andreban/neopixel-star/xiao/fab/jlcpcb/bom.csv

Comment | Designator | Footprint | LCSC Part #
10u | C1 | C_0603_1608Metric | C19702
WS2812B-Mini | LED1,LED2,LED3,LED4,LED5,LED6,LED7,LED8,LED9 | LED_WS2812B-Mini_PLCC4_3.5x3.5mm | C52941386
330 | R1 | R_0603_1608Metric | C23138
XIAO RP2350 | U1 | XIAO_Socket_2x07_P2.54mm_W15.24mm | C41882923
