andreban/neopixel-star/xiao/fab/pcbway/bom.csv

Item # | Designator | Qty | Manufacturer | Mfg Part # | Description / Value | Package/Footprint | Type | LCSC Part #
1 | C1 | 1 | Samsung | CL10A106KP8NNNC | 10u - 10 uF 10 V X5R 0603, bulk | C_0603_1608Metric | THT | C19702
2 | LED1,LED2,LED3,LED4,LED5,LED6,LED7,LED8,LED9 | 9 | Worldsemi | WS2812B-MINI-V6 | WS2812B-Mini - Addressable RGB LED, 3535 | LED_WS2812B-Mini_PLCC4_3.5x3.5mm | THT | C52941386
3 | R1 | 1 | UNI-ROYAL | 0603WAF3300T5E | 330 - 330 R 1% 0603, data series resistor | R_0603_1608Metric | THT | C23138
4 | U1 | 1 | Seeed Studio | 102010550 | XIAO RP2350 - Seeed Studio XIAO RP2350 in 2.54 mm female headers (any XIAO fits) | XIAO_Socket_2x07_P2.54mm_W15.24mm | THT | C41882923
