andreban/neopixel-star/tht/fab/jlcpcb/bom.csv

Comment | Designator | Footprint | LCSC Part #
10u | C1 | CP_Radial_D5.0mm_P2.00mm | C43347
JST-PH 3p | J1 | JST_PH_S3B-PH-K_1x03_P2.00mm_Horizontal | C157929
WS2812D-F5 | LED1,LED2,LED3,LED4,LED5,LED6,LED7,LED8,LED9 | LED_D5.0mm-4_RGB_Staggered_Pins | C190565
330 | R1 | R_Axial_DIN0207_L6.3mm_D2.5mm_P2.54mm_Vertical | C119313
