andreban/neopixel-star/smd/fab/jlcpcb/bom.csv

Comment | Designator | Footprint | LCSC Part #
100n | C1,C2,C3,C4,C5,C6,C7,C8,C9,C11 | C_0402_1005Metric | C1525
10u | C10 | C_0805_2012Metric | C15850
JST-PH 3p | J1 | JST_PH_S3B-PH-SM4-TB_1x03-1MP_P2.00mm_Horizontal | C265101
WS2812B | LED1,LED2,LED3,LED4,LED5,LED6,LED7,LED8,LED9 | LED_WS2812B_PLCC4_5.0x5.0mm_P3.2mm | C2761795
330 | R1 | R_0402_1005Metric | C25104
100k | R2 | R_0402_1005Metric | C25741
74AHCT1G125 | U1 | SOT-23-5 | C7484
