andreban/neopixel-star/hotplate/v2/fab/jlcpcb/bom.csv

Comment | Designator | Footprint | LCSC Part #
10u | C1 | C_0603_1608Metric | C19702
JST-PH 3p | J1 | JST_PH_S3B-PH-SM4-TB_1x03-1MP_P2.00mm_Horizontal | C265101
WS2812B-Mini | LED1,LED2,LED3,LED4,LED5,LED6,LED7,LED8,LED9 | LED_WS2812B-Mini_PLCC4_3.5x3.5mm | C52941386
330 | R1 | R_0603_1608Metric | C23138
