andreban/neopixel-star/hotplate/v2/easyeda/outline.dxf

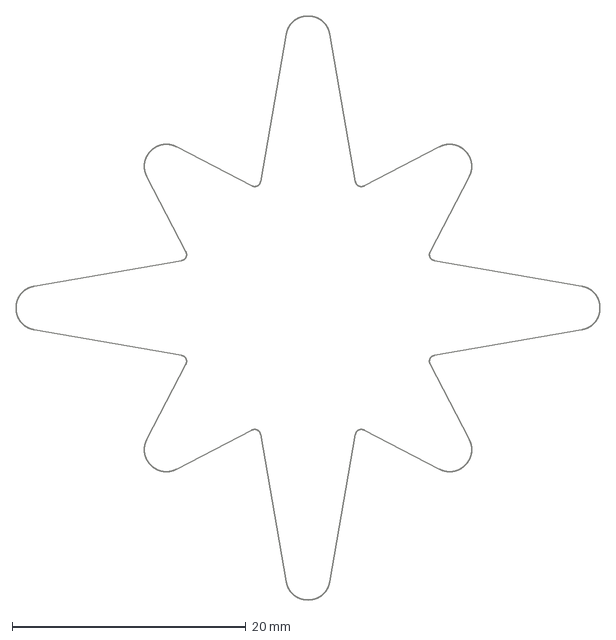
[picture p19: CAD file, 2026-09-26]
hotplate/v2/easyeda/outline.dxf
50.0 x 50.0 mm
