andreban/neopixel-star/tht/easyeda/outline.dxf

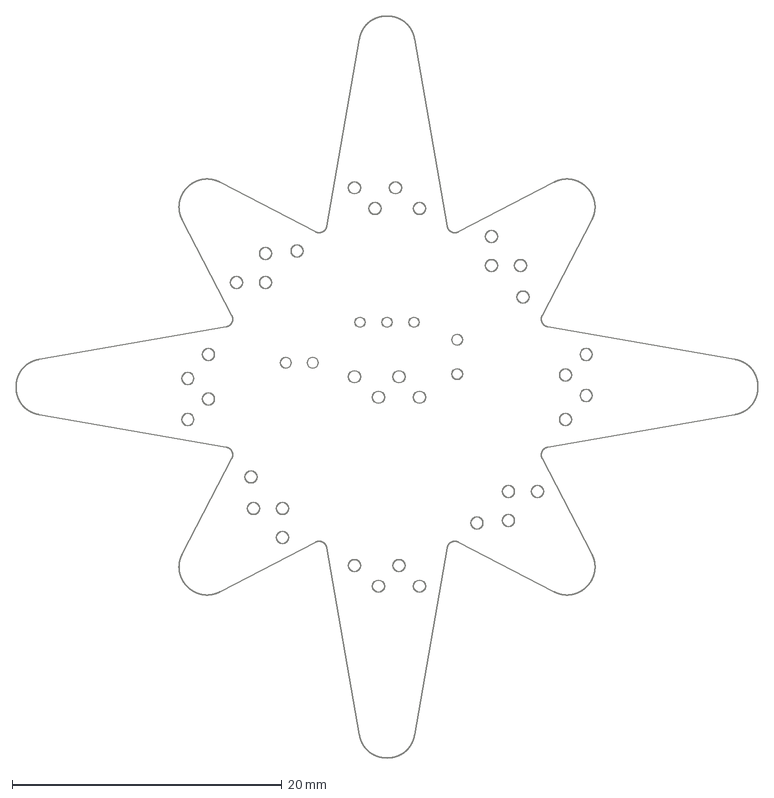
[picture p20: CAD file, 2026-10-20]
tht/easyeda/outline.dxf
55.0 x 55.0 mm
