andreban/neopixel-star/xiao/easyeda/outline.dxf

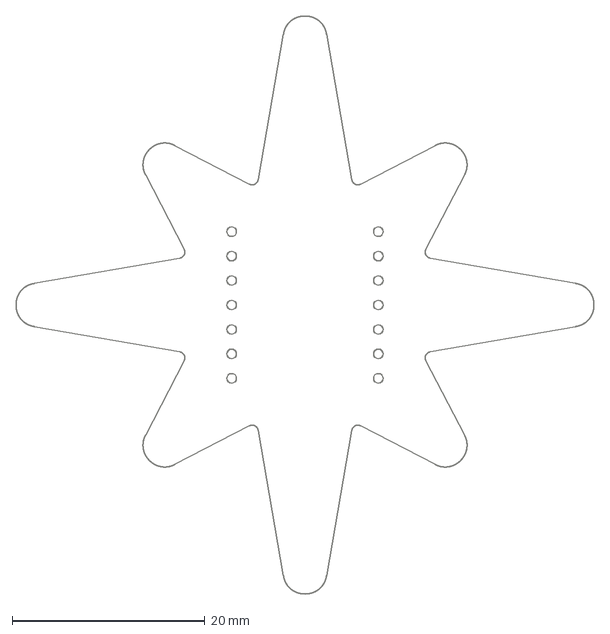
[picture p21: CAD file, 2026-11-06]
xiao/easyeda/outline.dxf
60.0 x 60.0 mm
