andreban/neopixel-star/xiao/docs/assembly.pdf

## NeoPixel Star (XIAO): front

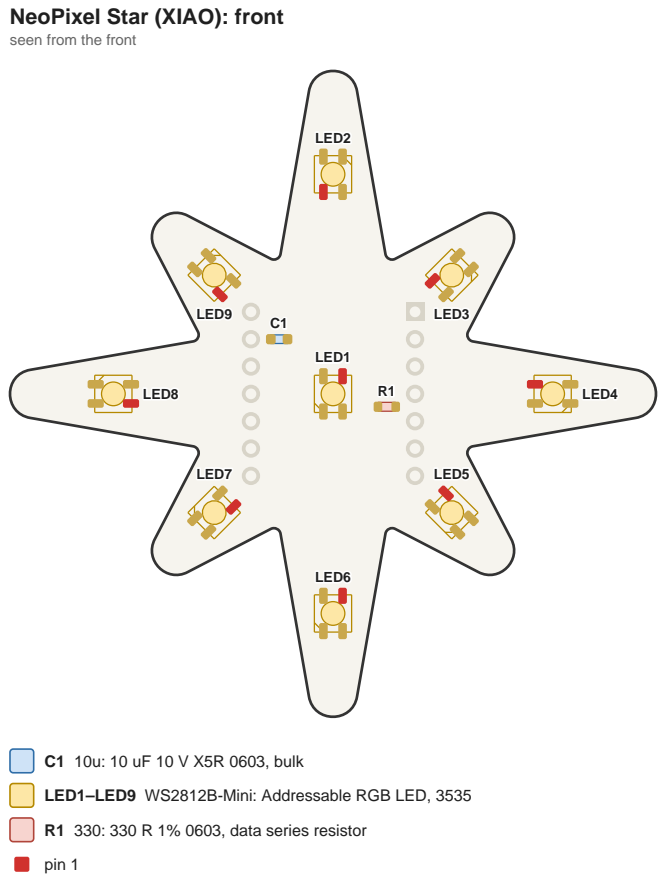
[picture p22: page 1]

seen from the front

C1 10u: 10 uF 10 V X5R 0603, bulk
LED1–LED9 WS2812B-Mini: Addressable RGB LED, 3535
R1 330: 330 R 1% 0603, data series resistor
pin 1

## NeoPixel Star (XIAO): back

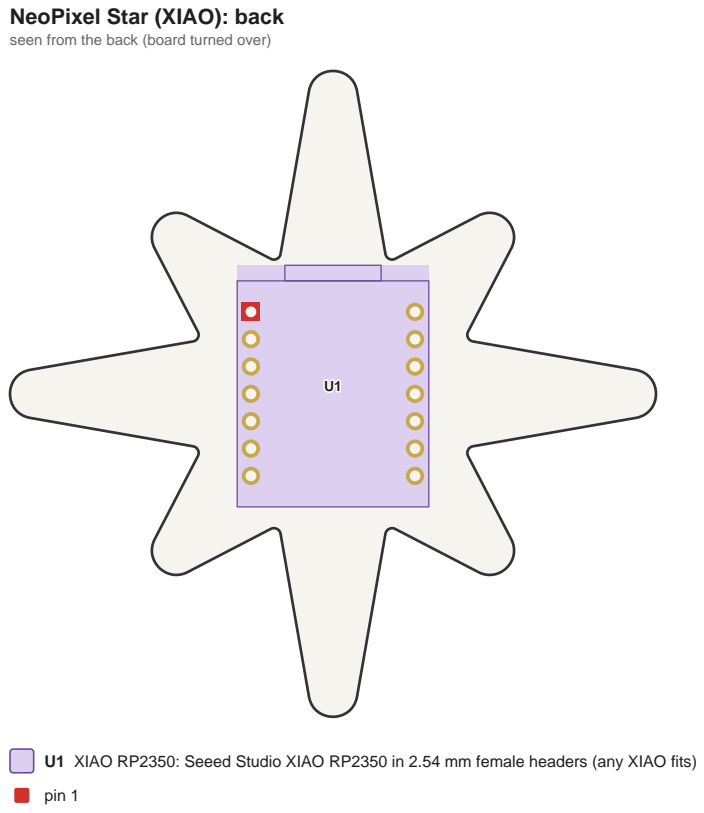
[picture p23: page 2]

seen from the back (board turned over)

U1 XIAO RP2350: Seeed Studio XIAO RP2350 in 2.54 mm female headers (any XIAO fits)
pin 1
