andreban/neopixel-star/xiao/docs/schematic.pdf

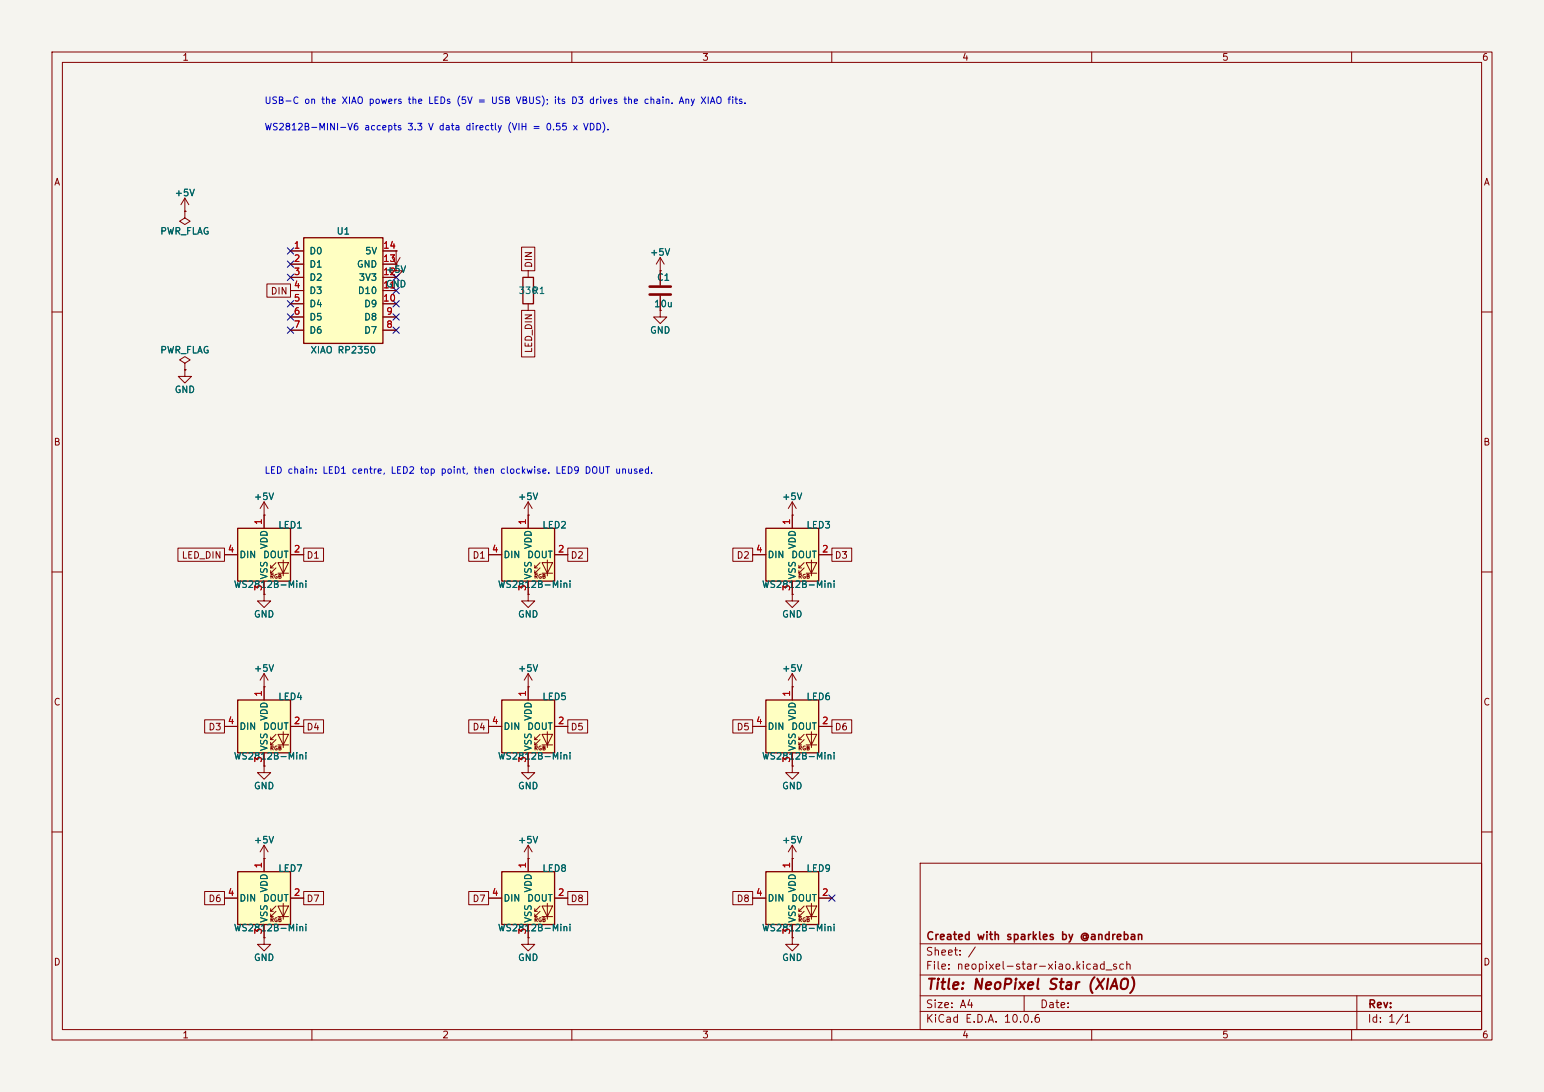
[picture p24: page 1]

Created with sparkles by @andreban
Sheet: /
File: neopixel-star-xiao.kicad_sch
Title: NeoPixel Star (XIAO)

Size: A4 | Rev:
KiCad E.D.A. 10.0.6 | Id: 1/1
