andreban/neopixel-star/smd/docs/assembly.pdf

## NeoPixel Star: front

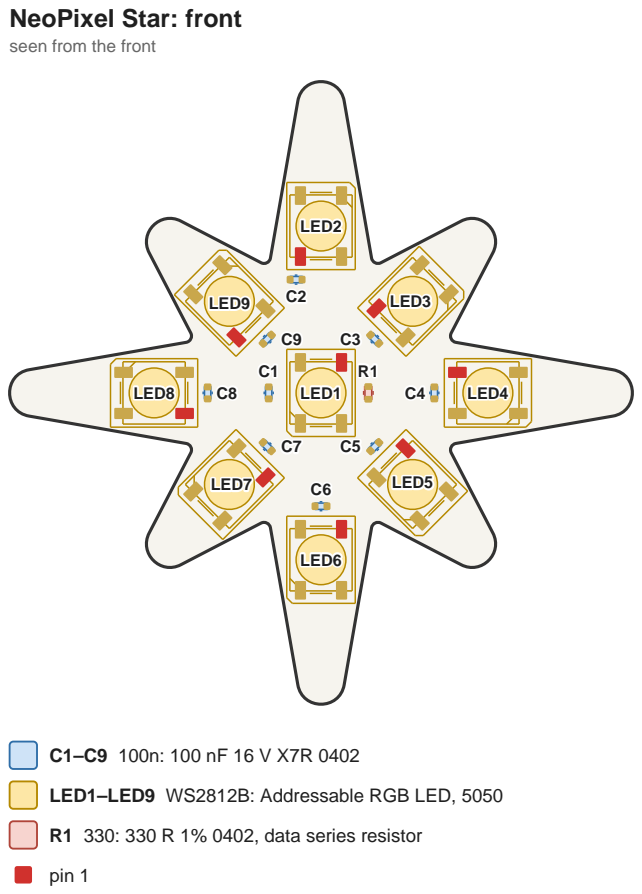
[picture p25: page 1]

seen from the front

## NeoPixel Star: back

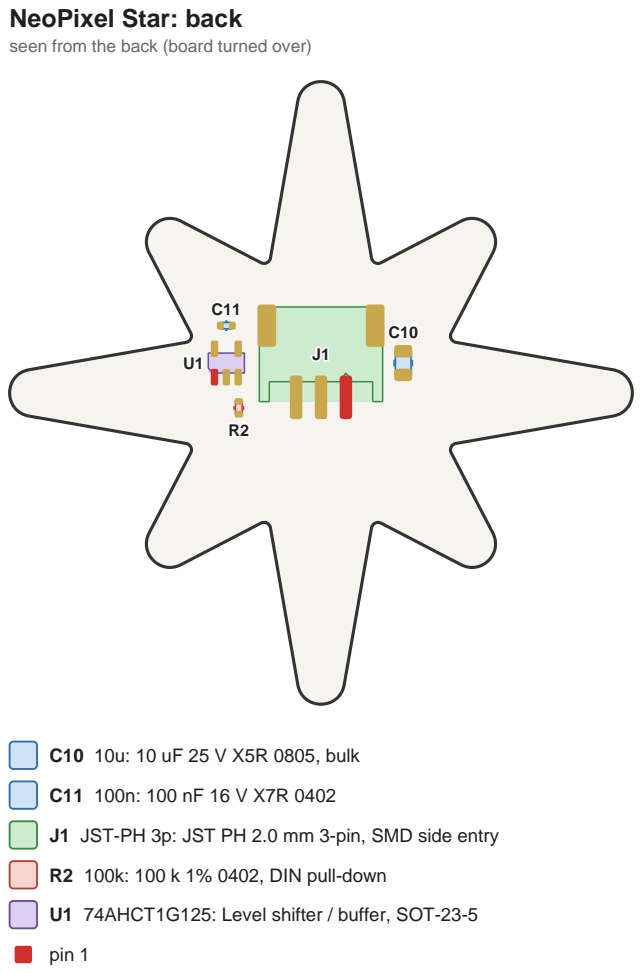
[picture p26: page 2]

seen from the back (board turned over)

C10 10u: 10 uF 25 V X5R 0805, bulk
J1 JST-PH 3p: JST PH 2.0 mm 3-pin, SMD side entry
R2 100k: 100 k 1% 0402, DIN pull-down
U1 74AHCT1G125: Level shifter / buffer, SOT-23-5
pin 1
