andreban/neopixel-star/tht/docs/assembly.pdf

## NeoPixel Star (through-hole): front

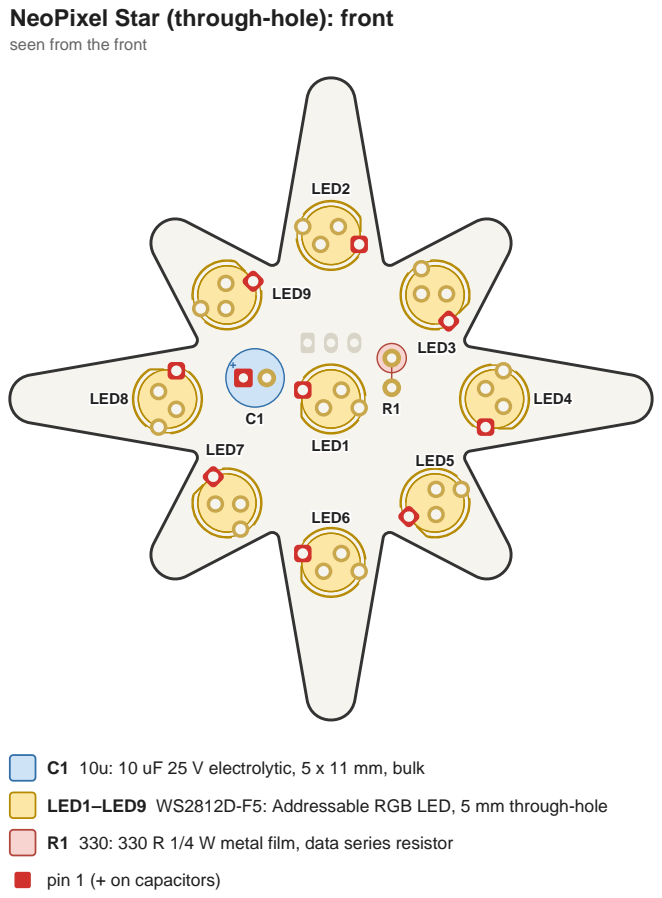
[picture p27: page 1]

seen from the front

C1 10u: 10 uF 25 V electrolytic, 5 x 11 mm, bulk
LED1–LED9 WS2812D-F5: Addressable RGB LED, 5 mm through-hole
R1 330: 330 R 1/4 W metal film, data series resistor
pin 1 (+ on capacitors)

## NeoPixel Star (through-hole): back

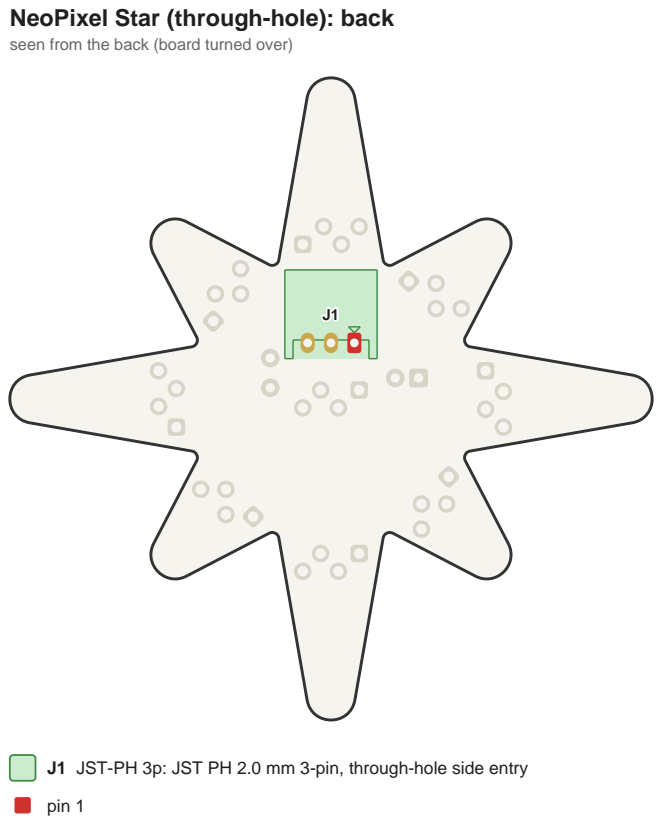
[picture p28: page 2]

seen from the back (board turned over)

J1 JST-PH 3p: JST PH 2.0 mm 3-pin, through-hole side entry
pin 1
