andreban/neopixel-star/hotplate/v2/docs/assembly.pdf

## NeoPixel Star (hot-plate v2): front

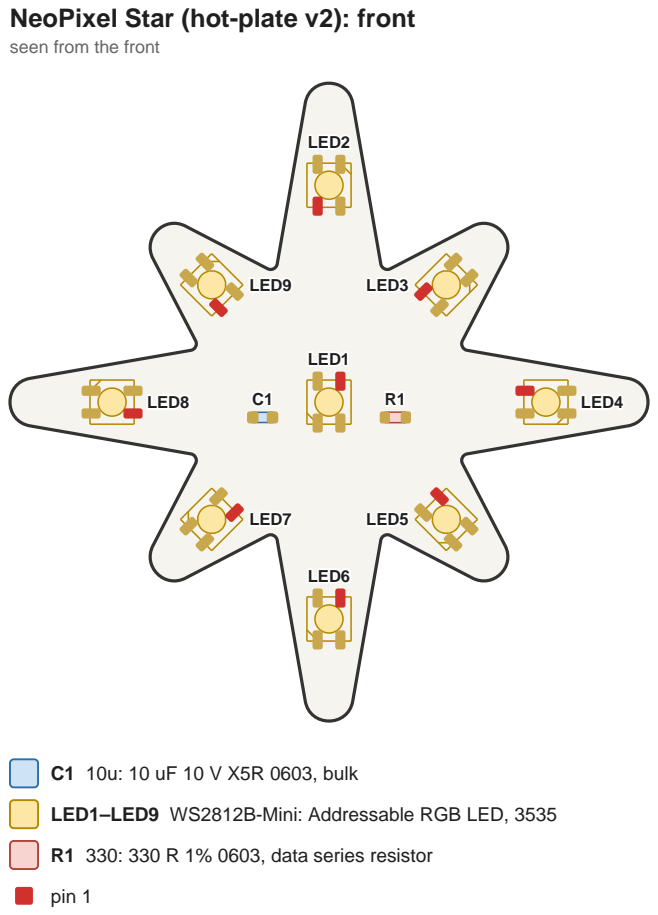
[picture p29: page 1]

seen from the front

C1 10u: 10 uF 10 V X5R 0603, bulk
LED1–LED9 WS2812B-Mini: Addressable RGB LED, 3535
R1 330: 330 R 1% 0603, data series resistor
pin 1

## NeoPixel Star (hot-plate v2): back

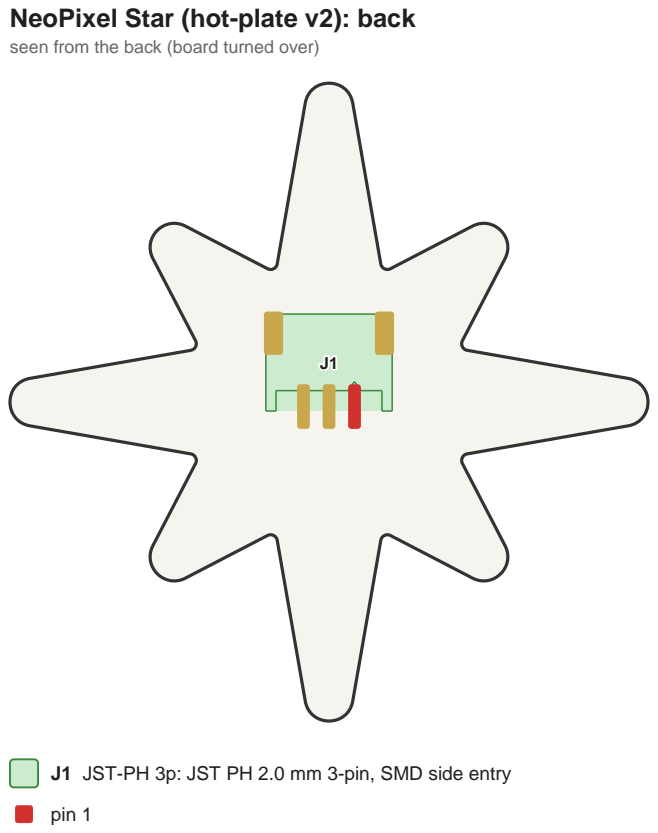
[picture p30: page 2]

seen from the back (board turned over)

J1 JST-PH 3p: JST PH 2.0 mm 3-pin, SMD side entry
pin 1
