andreban/neopixel-star/smd/docs/schematic.pdf

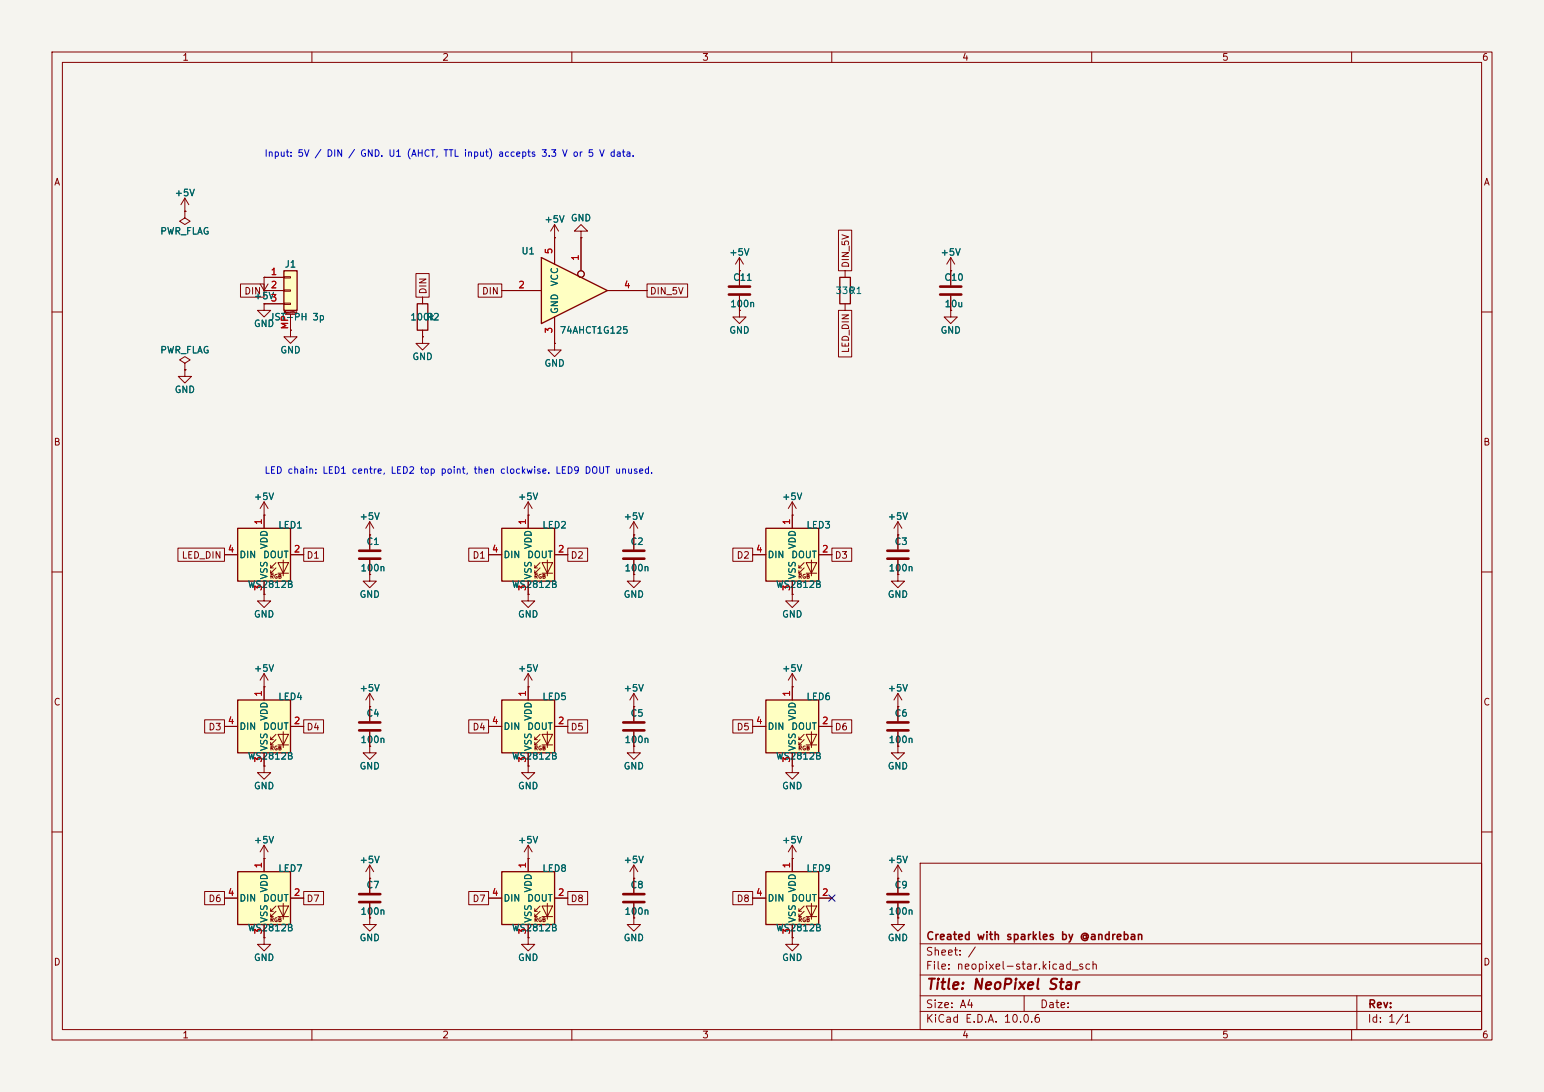
[picture p31: page 1]

LED chain: LED1 centre, LED2 top point, then clockwise. LED9 DOUT unused.

Created with sparkles by @andreban
Sheet: /
File: neopixel-star.kicad_sch
Title: NeoPixel Star

Size: A4 | Rev:
KiCad E.D.A. 10.0.6 | Id: 1/1
