andreban/neopixel-star/tht/docs/schematic.pdf

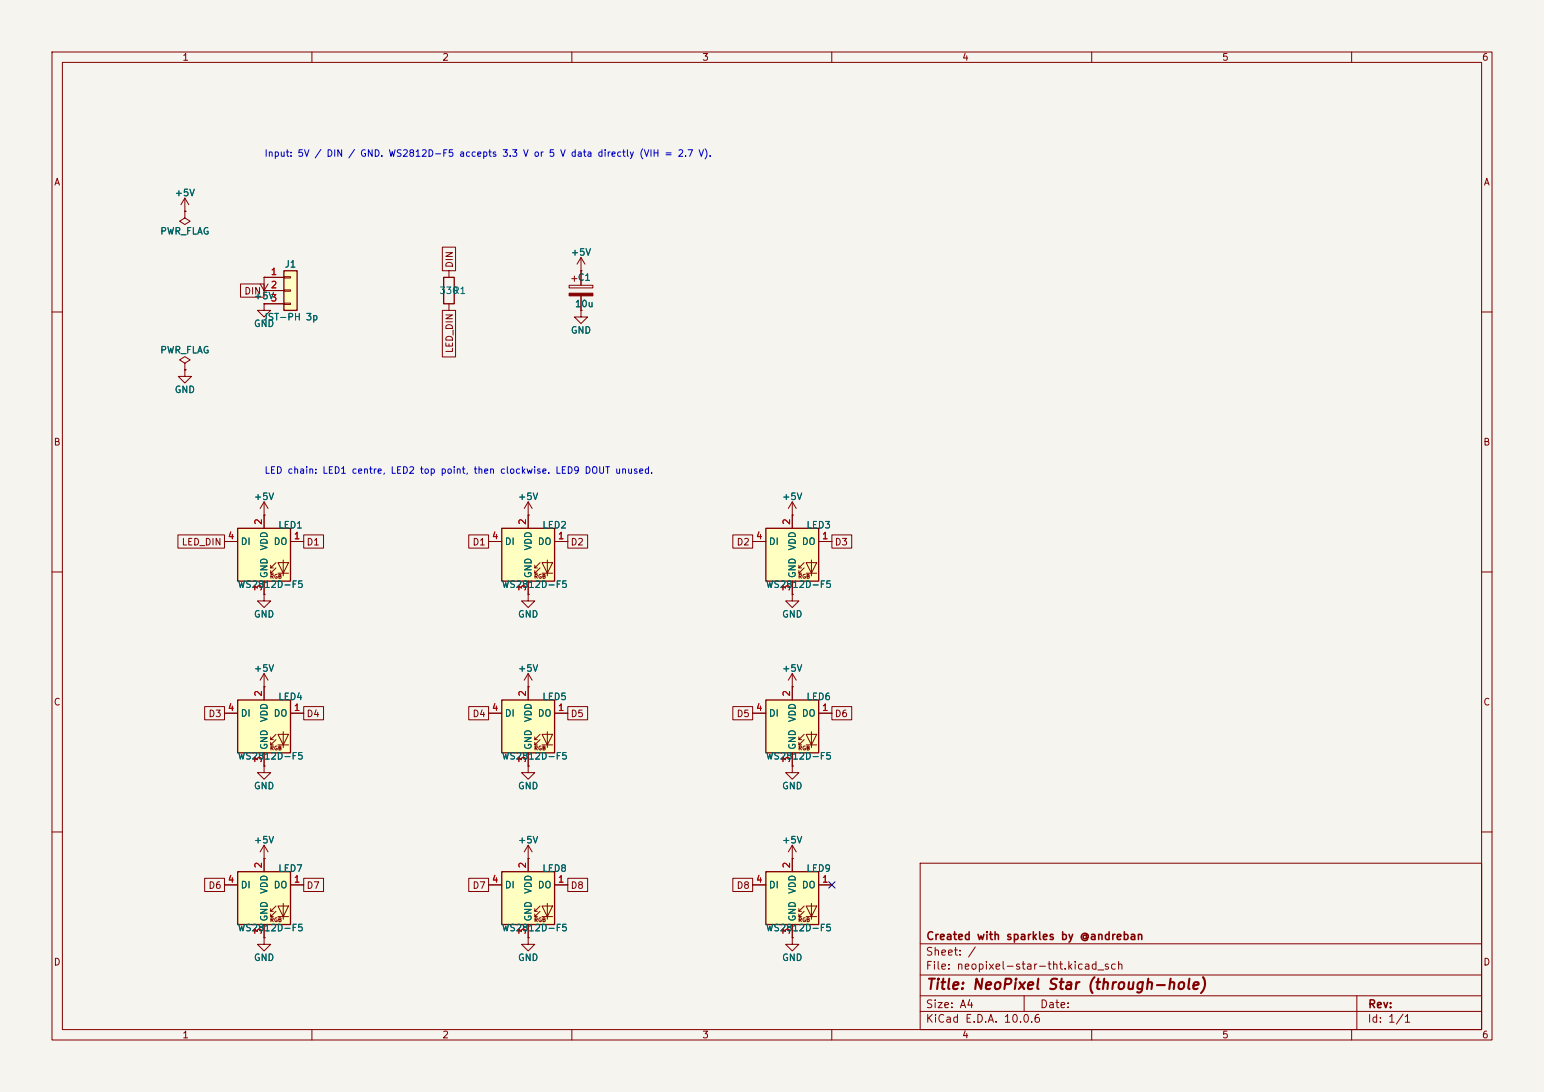
[picture p32: page 1]

Input: 5V / DIN / GND. WS2812D-F5 accepts 3.3 V or 5 V data directly (VIH = 2.7 V). LED chain: LED1 centre, LED2 top point, then clockwise. LED9 DOUT unused. +5V

Created with sparkles by @andreban
Sheet: /
File: neopixel-star-tht.kicad_sch
Title: NeoPixel Star (through-hole)

Size: A4 | Rev:
KiCad E.D.A. 10.0.6 | Id: 1/1
