andreban/neopixel-star/hotplate/v1/docs/assembly.pdf

## NeoPixel Star (hot-plate): front

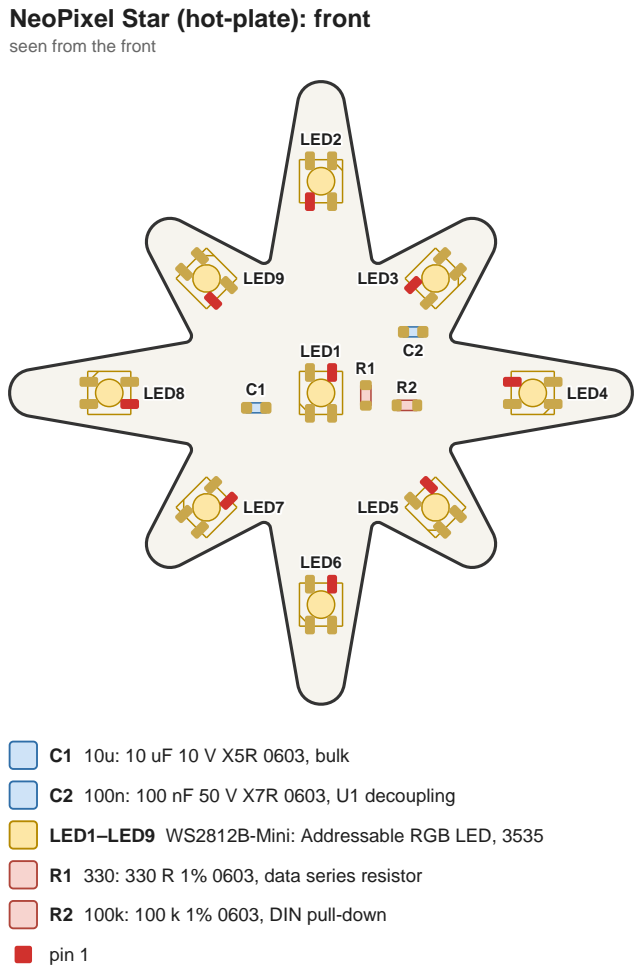
[picture p33: page 1]

seen from the front

C1 10u: 10 uF 10 V X5R 0603, bulk
C2 100n: 100 nF 50 V X7R 0603, U1 decoupling
LED1–LED9 WS2812B-Mini: Addressable RGB LED, 3535
R1 330: 330 R 1% 0603, data series resistor
R2 100k: 100 k 1% 0603, DIN pull-down
pin 1

## NeoPixel Star (hot-plate): back

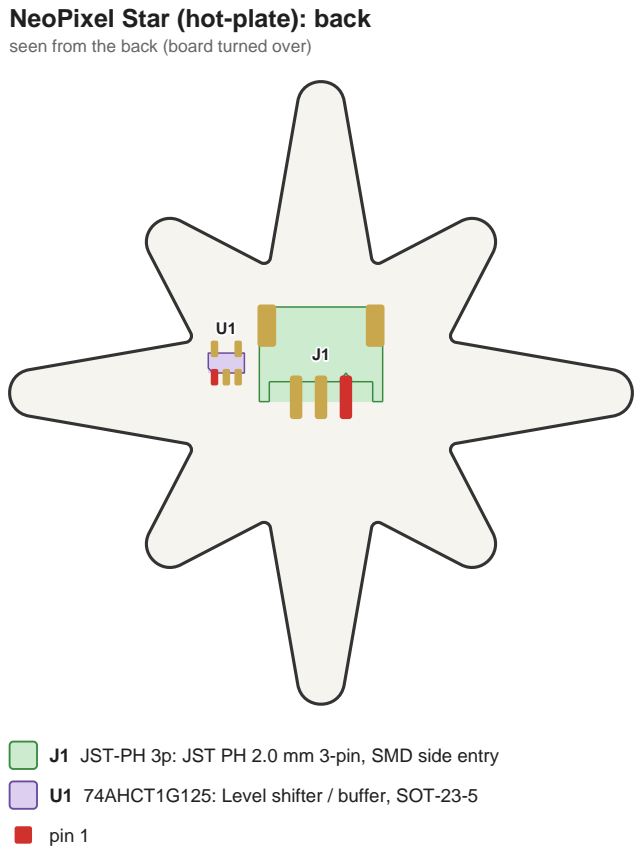
[picture p34: page 2]

seen from the back (board turned over)

J1 JST-PH 3p: JST PH 2.0 mm 3-pin, SMD side entry
U1 74AHCT1G125: Level shifter / buffer, SOT-23-5
pin 1
