andreban/neopixel-star/hotplate/v2/docs/schematic.pdf

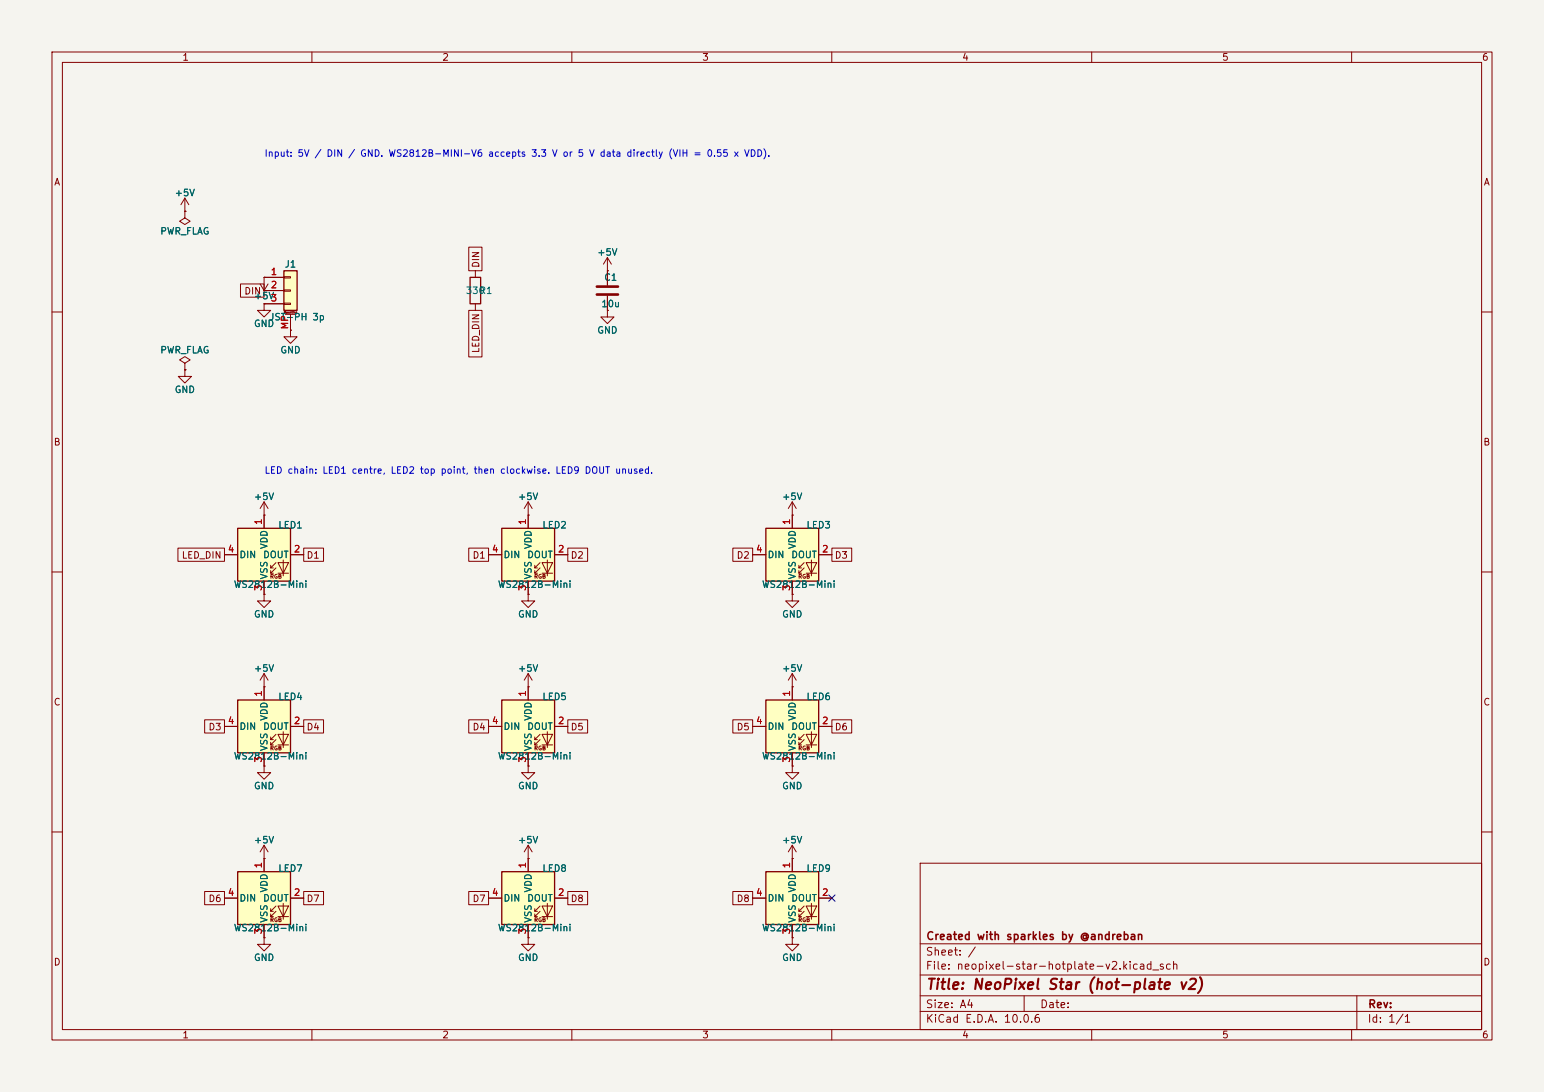
[picture p35: page 1]

Input: 5V / DIN / GND. WS2812B-MINI-V6 accepts 3.3 V or 5 V data directly (VIH = 0.55 x VDD). +5V

LED chain: LED1 centre, LED2 top point, then clockwise. LED9 DOUT unused.

Created with sparkles by @andreban
Sheet: /
File: neopixel-star-hotplate-v2.kicad_sch
Title: NeoPixel Star (hot-plate v2)

Size: A4 | Rev:
KiCad E.D.A. 10.0.6 | Id: 1/1
