andreban/neopixel-star/xiao/kicad/neopixel-star-xiao.kicad_pcb

## KiCad design xiao/kicad/neopixel-star-xiao.kicad_pcb (2026-11-07)

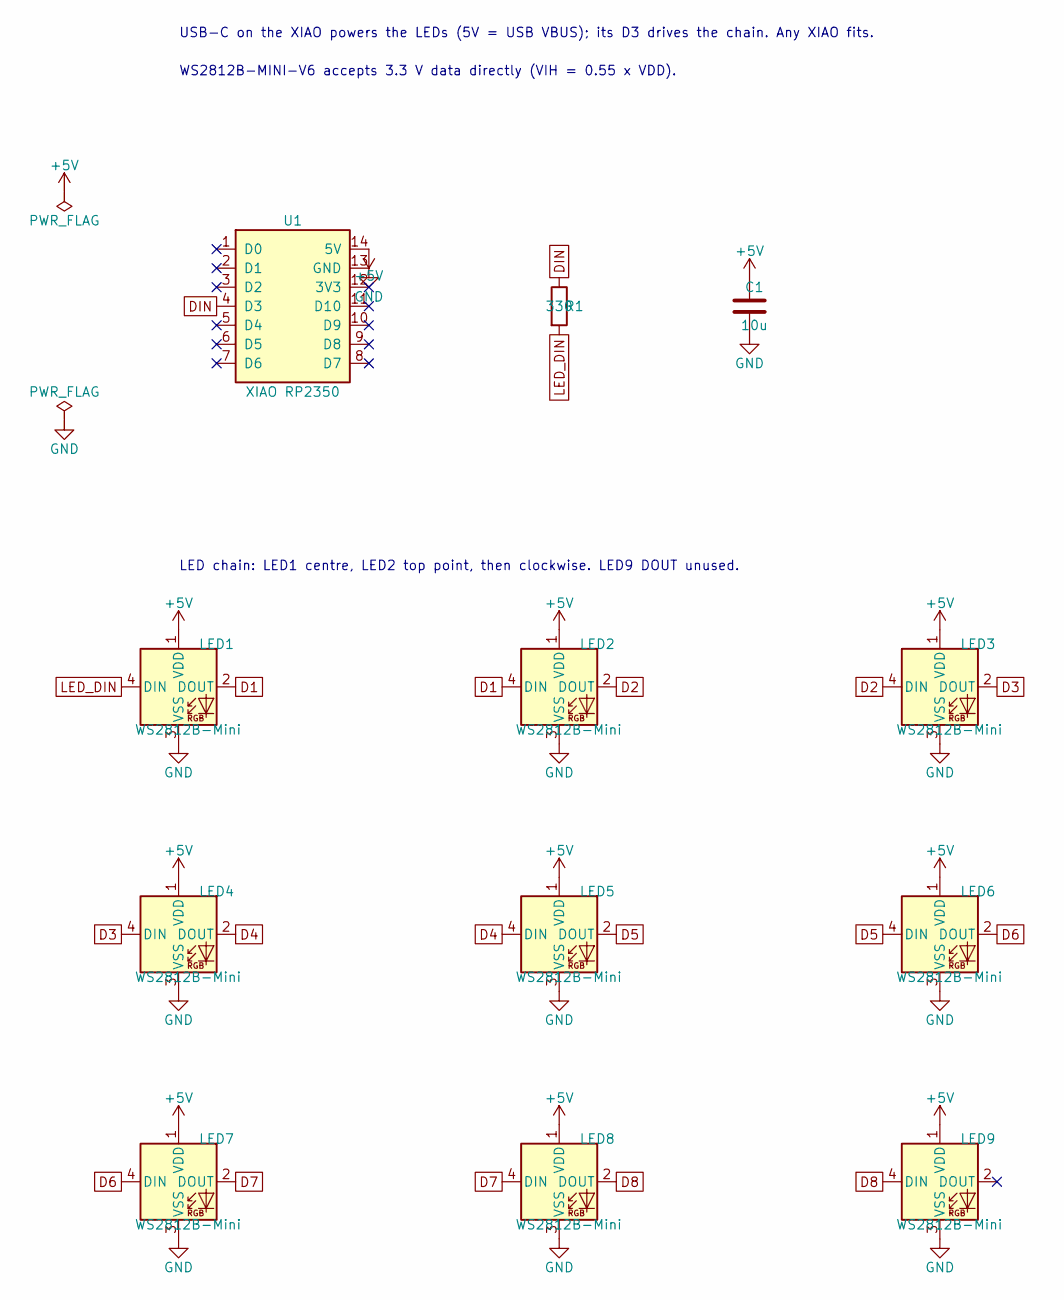
[picture p36: schematic neopixel-star-xiao.kicad_sch, NeoPixel Star (XIAO)]

Parts:
C1: 10u; C_0603_1608Metric; MPN CL10A106KP8NNNC; LCSC C19702
LED1, LED2, LED3, LED4, LED5, LED6, LED7, LED8, LED9: WS2812B-Mini; LED_WS2812B-Mini_PLCC4_3.5x3.5mm; MPN WS2812B-MINI-V6; LCSC C52941386
R1: 330; R_0603_1608Metric; MPN 0603WAF3300T5E; LCSC C23138
U1: XIAO RP2350; XIAO_Socket_2x07_P2.54mm_W15.24mm; MPN 102010550; LCSC C41882923

Connections:
+5V: C1.1, LED1.1 (VDD), LED2.1 (VDD), LED3.1 (VDD), LED4.1 (VDD), LED5.1 (VDD), LED6.1 (VDD), LED7.1 (VDD), LED8.1 (VDD), LED9.1 (VDD), U1.14 (5V)
D1: LED1.2 (DOUT), LED2.4 (DIN)
D2: LED2.2 (DOUT), LED3.4 (DIN)
D3: LED3.2 (DOUT), LED4.4 (DIN)
D4: LED4.2 (DOUT), LED5.4 (DIN)
D5: LED5.2 (DOUT), LED6.4 (DIN)
D6: LED6.2 (DOUT), LED7.4 (DIN)
D7: LED7.2 (DOUT), LED8.4 (DIN)
D8: LED8.2 (DOUT), LED9.4 (DIN)
DIN: R1.1, U1.4 (D3)
GND: C1.2, LED1.3 (VSS), LED2.3 (VSS), LED3.3 (VSS), LED4.3 (VSS), LED5.3 (VSS), LED6.3 (VSS), LED7.3 (VSS), LED8.3 (VSS), LED9.3 (VSS), U1.13 (GND)
LED_DIN: LED1.4 (DIN), R1.2

Notes on the sheet:
USB-C on the XIAO powers the LEDs (5V = USB VBUS); its D3 drives the chain. Any XIAO fits.
WS2812B-MINI-V6 accepts 3.3 V data directly (VIH = 0.55 x VDD).
LED chain: LED1 centre, LED2 top point, then clockwise. LED9 DOUT unused.

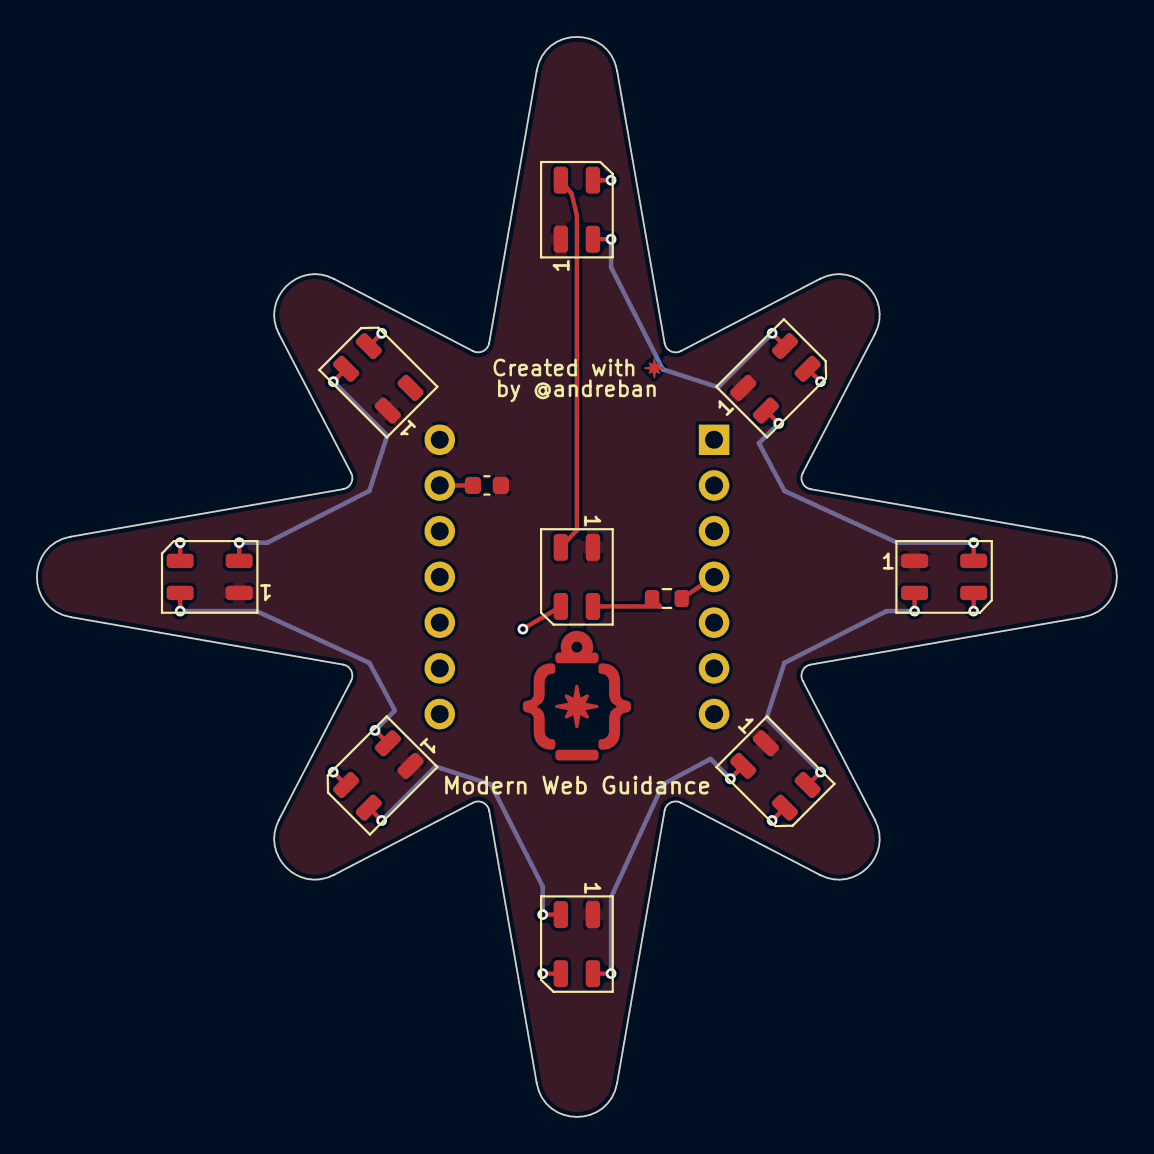
[picture p37: board neopixel-star-xiao.kicad_pcb from above]

Board: 2 copper layers, 60.0 x 60.0 mm, 12 parts (1 on the bottom side), 12 nets.
