andreban/neopixel-star/tht/kicad/neopixel-star-tht.kicad_pcb

## KiCad design tht/kicad/neopixel-star-tht.kicad_pcb (2026-10-20)

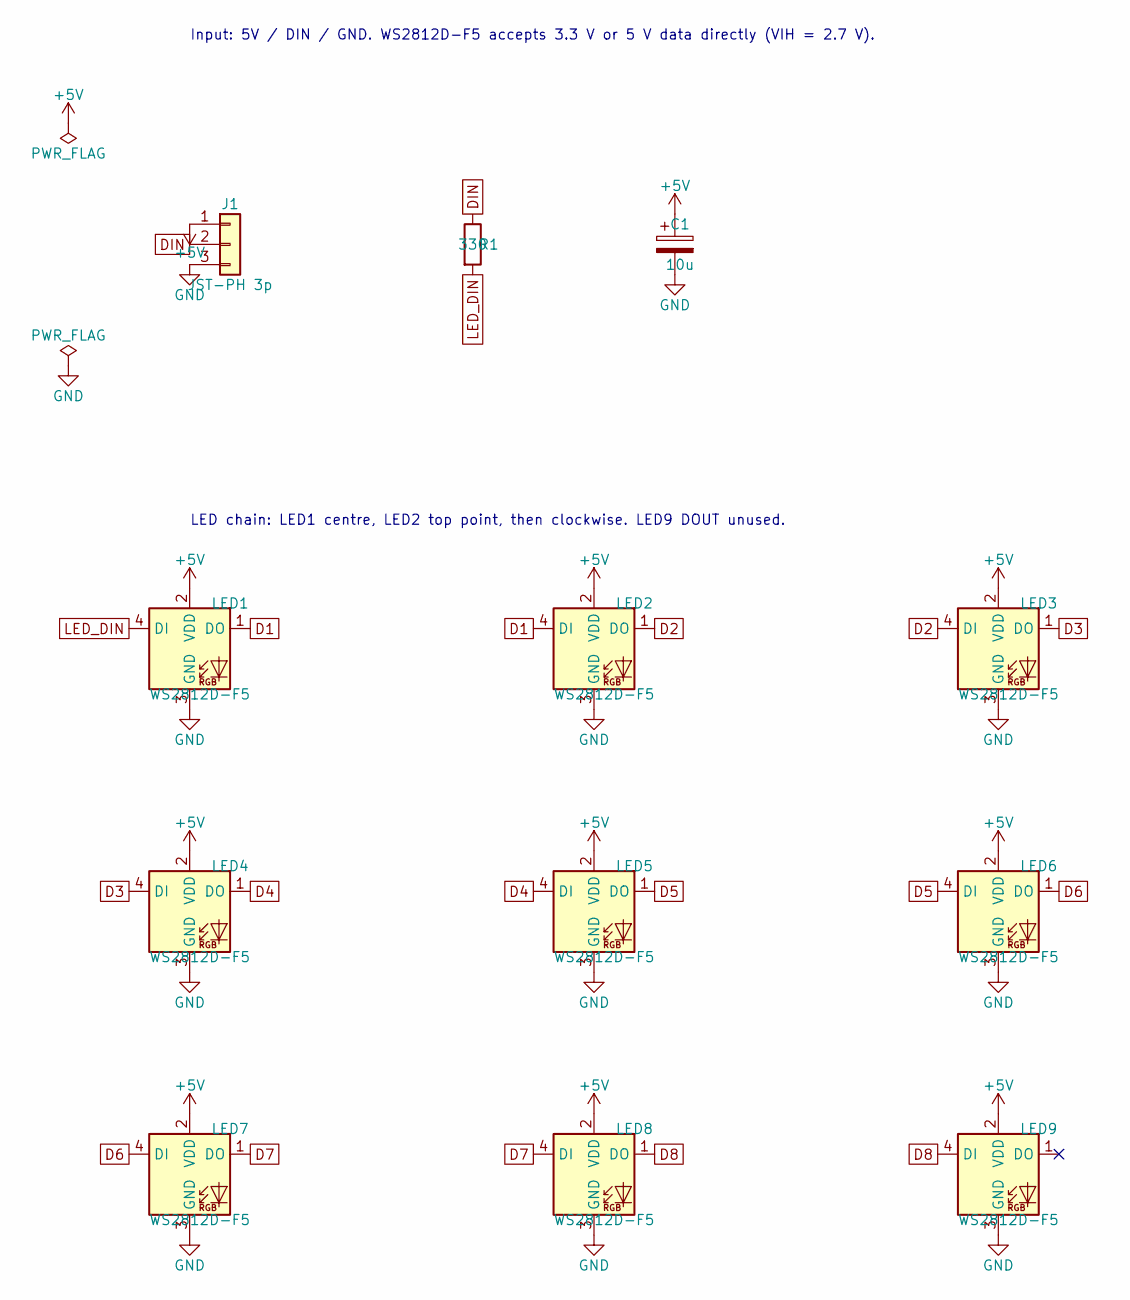
[picture p38: schematic neopixel-star-tht.kicad_sch, NeoPixel Star (through-hole)]

Parts:
C1: 10u; CP_Radial_D5.0mm_P2.00mm; MPN KM106M025D11RR0VH2FP0; LCSC C43347
J1: JST-PH 3p; JST_PH_S3B-PH-K_1x03_P2.00mm_Horizontal; MPN S3B-PH-K-S(LF)(SN); LCSC C157929
LED1, LED2, LED3, LED4, LED5, LED6, LED7, LED8, LED9: WS2812D-F5; LED_D5.0mm-4_RGB_Staggered_Pins; MPN WS2812D-F5; LCSC C190565
R1: 330; R_Axial_DIN0207_L6.3mm_D2.5mm_P2.54mm_Vertical; MPN MF1/4W-330R 1%; LCSC C119313

Connections:
+5V: C1.1, J1.1, LED1.2 (VDD), LED2.2 (VDD), LED3.2 (VDD), LED4.2 (VDD), LED5.2 (VDD), LED6.2 (VDD), LED7.2 (VDD), LED8.2 (VDD), LED9.2 (VDD)
D1: LED1.1 (DO), LED2.4 (DI)
D2: LED2.1 (DO), LED3.4 (DI)
D3: LED3.1 (DO), LED4.4 (DI)
D4: LED4.1 (DO), LED5.4 (DI)
D5: LED5.1 (DO), LED6.4 (DI)
D6: LED6.1 (DO), LED7.4 (DI)
D7: LED7.1 (DO), LED8.4 (DI)
D8: LED8.1 (DO), LED9.4 (DI)
DIN: J1.2, R1.1
GND: C1.2, J1.3, LED1.3 (GND), LED2.3 (GND), LED3.3 (GND), LED4.3 (GND), LED5.3 (GND), LED6.3 (GND), LED7.3 (GND), LED8.3 (GND), LED9.3 (GND)
LED_DIN: LED1.4 (DI), R1.2

Notes on the sheet:
Input: 5V / DIN / GND. WS2812D-F5 accepts 3.3 V or 5 V data directly (VIH = 2.7 V).
LED chain: LED1 centre, LED2 top point, then clockwise. LED9 DOUT unused.

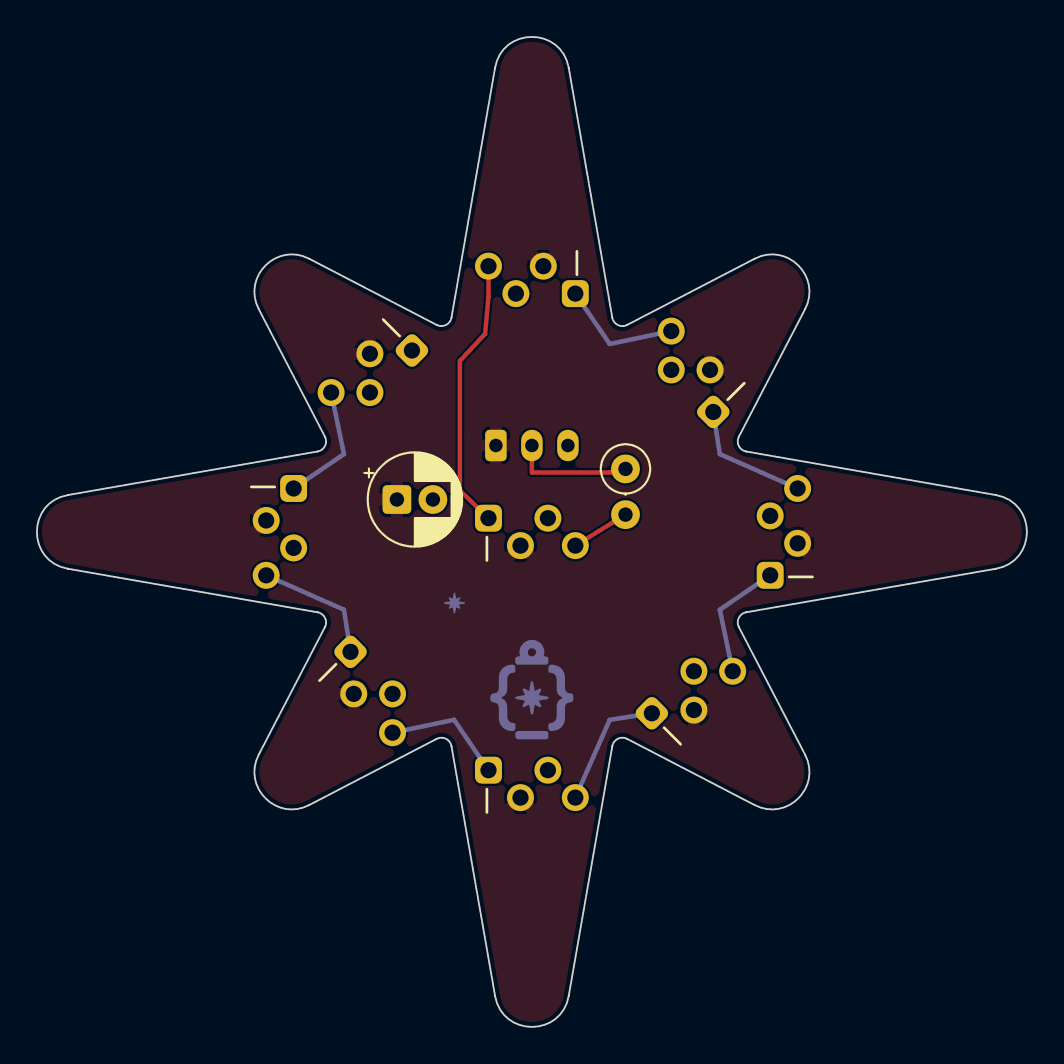
[picture p39: board neopixel-star-tht.kicad_pcb from above]

Board: 2 copper layers, 55.0 x 55.0 mm, 12 parts (1 on the bottom side), 12 nets.
