andreban/neopixel-star/(commit log)

2026-09-26 Initial plan and reference logo for NeoPixel star PCB
2026-09-26 Generate star PCB with KiCad: outline, LEDs, level shifter, routing, artwork
    Board passes KiCad DRC with zero violations and no unconnected pads.
    [neopixel-star.kicad_pcb]
2026-09-26 Add generated schematic (ERC clean) with project symbol library
    Board and schematic share scripts/parts.py; DRC passes with schematic
    parity. Correct the JST part to LCSC C265101 (3-pin).
    [neopixel-star.kicad_pcb, neopixel-star.kicad_sch]
2026-09-26 Add fab outputs (Gerbers, JLCPCB/PCBWay BOM+placement), EasyEDA package, renders, README
    scripts/build_all.py regenerates, checks (ERC/DRC/parity) and exports everything.
    [bom.csv, centroid.csv, neopixel-star.kicad_pcb, outline.dxf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]
2026-09-26 Add generated 3D model for the SMD JST connector and angled renders
    [neopixel-star.kicad_pcb]
2026-09-26 Use global labels so net names carry no sheet prefix
    EasyEDA's import compared schematic net 'D1' with PCB net '/D1' and
    reported a netlist mismatch on every labelled net.
    [neopixel-star.kicad_pcb, neopixel-star.kicad_sch]
2026-09-26 Rebuild outputs
    [neopixel-star.kicad_pcb]
2026-09-26 README: status, Arduino example, EasyEDA import notes, repo layout, credits
2026-09-26 AGENTS.md: document KiCad 10 and Python prerequisites
2026-09-26 Detect KiCad 10 install instead of hardcoding a local path
    Checks KICAD_DIR, then the standard install locations on Windows,
    macOS and Linux.
    [neopixel-star.kicad_pcb]
2026-09-26 PLAN: record through-hole variant decisions
2026-09-26 Add through-hole variant (tht/): 55 mm, WS2812D-F5, hand-solderable
    Same scripts build both boards via scripts/variants.py; the SMD design is
    unchanged. WS2812D-F5 accepts 3.3 V data directly, so no level shifter or
    diode; the datasheet needs no per-LED caps. Corrected WS2812D-F5 symbol
    (KiCad's APA-106-F5 swaps VDD/GND). ERC, DRC and schematic parity clean
    for both variants.
    [bom.csv, centroid.csv, neopixel-star-tht.kicad_pcb, neopixel-star-tht.kicad_sch, neopixel-star.kicad_pcb, outline.dxf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]
2026-09-26 Reorganize into symmetric smd/ and tht/ variants
    - Outputs: smd/ and tht/, each with README, kicad/, fab/, easyeda/, docs/
    - Scripts: common/ (shared machinery), smd/ and tht/ (parts, layout,
    schematic per variant); entry points and commands unchanged
    - Root README is now an overview with the shared wiring/power/code notes
    Both designs are unchanged: identical parts, tracks, vias, nets,
    schematics, BOMs and placement files; ERC/DRC/parity clean.
    [bom.csv, centroid.csv, neopixel-star-tht.kicad_pcb, neopixel-star.kicad_pcb, neopixel-star.kicad_sch, outline.dxf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]
2026-09-26 Add hot-plate variant (hotplate/): 3535 LEDs, all paste parts on the front
    Front reflows on a hot plate with the back bare; only J1 and U1 go on the
    back, by iron. WS2812B-MINI-V3/W needs no per-LED caps; LEDs sit further
    into the points than on the 5050 board. ERC, DRC and schematic parity clean
    for all three variants; SMD and THT designs unchanged.
    [bom.csv, centroid.csv, neopixel-star-hotplate.kicad_pcb, neopixel-star-hotplate.kicad_sch, neopixel-star-tht.kicad_pcb, neopixel-star.kicad_pcb, outline.dxf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]
2026-09-26 Hot-plate: move title and gold logo to the front
    Split the shared artwork into side-aware helpers (title, logo, credit,
    pin_labels); artwork() keeps the SMD/THT back unchanged (verified).
    [neopixel-star-hotplate.kicad_pcb, neopixel-star-tht.kicad_pcb, neopixel-star.kicad_pcb, outline.dxf]
2026-10-06 Add hotplate/v2 (WS2812B-MINI-V6, no level shifter) and move v1 to hotplate/v1
    WS2812B-MINI-V6 (LCSC C52941386) lowers VIH to 0.55 x VDD (2.75 V at 5 V), so 3.3 V logic drives DIN directly. Move the existing WS2812B-MINI-V3/W + U1 design to hotplate/v1 and add hotplate/v2 without U1, C2 and R2 (leaving only J1 on the back). ERC, DRC and schematic parity clean across all four variants.
    [bom.csv, centroid.csv, neopixel-star-hotplate-v2.kicad_pcb, neopixel-star-hotplate-v2.kicad_sch, neopixel-star-hotplate.kicad_pcb, neopixel-star-hotplate.kicad_sch, outline.dxf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]
2026-10-20 Add assembly drawings showing which part goes where
    New scripts/common/assembly.py reads the saved .kicad_pcb (plain Python,
    no pcbnew) and writes docs/assembly-front.svg and docs/assembly-back.svg
    for each variant: board outline, pads, fab-layer bodies, reference
    designators and a legend of values. Pin 1 is marked in red on every
    polarized part (+ on the THT electrolytic). The back is mirrored, as seen
    with the board turned over.
    References sit on the part when they fit clear of the pads, otherwise
    beside it, placed so each reads as its own part's label.
    build_all.py generates them in the docs step; the variant READMEs show
    them under the renders.
2026-10-20 Add a printable assembly PDF per variant
    docs/assembly.pdf has the front drawing on page 1 and the back on page 2,
    A4, both at the same scale, so a double-sided print gives one sheet.
    New scripts/common/pdf.py converts the SVG subset assembly.py writes to
    PDF in plain Python, using the built-in Helvetica (no embedded font), so
    the PDF matches the SVGs. Output is deterministic. To support it,
    assembly.py now writes arcs as Béziers, gives text an explicit baseline,
    and measures labels with Helvetica's real widths.
2026-10-20 Address review: align PDF pages, fix build summary, document KiCad version
    - pdf.py: all pages share one top edge (from the tallest drawing), so the
    front and mirrored back line up when printed double-sided. Before, each
    page was centred on its own height, which differs with the legend length.
    - build_all.py: the docs summary lists assembly.pdf too.
    - README: the Rebuilding paragraph mentions the assembly drawings.
    - AGENTS.md: outputs are built with KiCad 10.0.6; another version
    reorders the board and changes PNG/PDF bytes without a design change.
    [build_all.py]
2026-10-20 Rebuild all outputs with KiCad 10.0.6
    No design change: ERC, DRC and schematic parity are clean for every
    variant. KiCad 10.0.6 saves footprints in a different order, and the
    renders, schematic PDFs and zips come out with different bytes.
    Committed separately so the design commits stay readable, and so a
    rebuild with 10.0.6 leaves the tree clean.
    [neopixel-star-hotplate-v2.kicad_pcb, neopixel-star-hotplate.kicad_pcb, neopixel-star-tht.kicad_pcb, neopixel-star.kicad_pcb, outline.dxf]
2026-10-20 Make builds reproducible
    A rebuild with no design change now leaves every output byte-identical
    (verified: two consecutive full builds, second one changes nothing).
    - build_board.py seeds KiCad's UUID generator per variant. Unseeded,
    every item got a random UUID and KiCad saves footprints sorted by UUID,
    so the board file reshuffled on every build. This, not the KiCad
    version as the previous commit said, was the source of the board churn.
    - build_all.py leaves Gerber/drill zips and the schematic PDF alone when
    only KiCad's embedded timestamps changed, and writes zips with fixed
    entry dates and sorted entries.
    - The ray-traced renders differ on every run, so they're redone only whe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
    [neopixel-star-hotplate-v2.kicad_pcb, neopixel-star-hotplate.kicad_pcb, neopixel-star-tht.kicad_pcb, neopixel-star.kicad_pcb, outline.dxf]
2026-10-20 Commit the render fingerprint so a fresh checkout builds clean
    Review: the fingerprint lived in the gitignored build/, so the first build
    in a fresh checkout re-rendered and rewrote the committed PNGs with
    different bytes. It now sits next to the renders (docs/renders.sha256) and
    is committed with them. Line endings are stripped before hashing, since
    KiCad writes CRLF on Windows and LF elsewhere.
2026-11-06 Add a XIAO version: microcontroller and USB-C on the board
    A 60 mm star with hot-plate v2's front (WS2812B-MINI-V6, R1, C1) and a
    Seeed XIAO plugged into two 1x7 female headers on the back. Its 5V pin
    (USB VBUS) powers the LEDs and D3 drives the chain. Any XIAO fits: only
    the 14 edge pins common to every model are used.
    The headers lift the module 11 mm, so a USB-C plug clears the star.
    Soldered flat, the plug's overmold runs into the points beside any notch,
    and a slot wide enough for it spoils the logo's outline.
    - common/xiao.py: generated footprint, symbol and VRML model (KiCad
    ships none); parts with lib "generated" come from it
    - Part.pin_names, for symbols with several unconnected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
    [bom.csv, centroid.csv, neopixel-star-xiao.kicad_pcb, neopixel-star-xiao.kicad_sch, outline.dxf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]
2026-11-07 XIAO version: list the XIAO RP2350 as U1
    The BOM now names the XIAO RP2350 (102010550, LCSC C41882923). The README
    documents both Raspberry Pi XIAOs, with their LCSC numbers and the GPIO
    behind D3 (GPIO5 on the RP2350, GPIO29 on the RP2040) for MicroPython.
    [bom.csv, centroid.csv, neopixel-star-xiao.kicad_pcb, neopixel-star-xiao.kicad_sch]
